ut-robotics/picr22-team-gibibot/(threads)

Thread 1 (2022-09-21):

[Mechanics] Add thrower to robot assembly

maidlam, 2022-09-21:
Add the thrower to the test robot assembly to check for any possible interference issues.

marcanderetti, 2022-09-22:
already did that, everything fits fine

marcanderetti, 2022-09-22:
Check the example subfolder - chassis assembling

Closed 2022-09-24.

Thread 10 (2022-09-21):

[Mechanics] How are the ball guides going to be fixed in place

maidlam, 2022-09-21:
How are the ball guides going to be fixed in place so they don't move around when in use?

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

marcanderetti, 2022-09-21:
The sticks will be replaced by M6 bolts

Akustav, 2022-09-24:
You need 70mm M6 bolts to make them work. I hope you have those, since I dont think we have such bolts in the lab and they seem quite exotic in their usecases.

marcanderetti, 2022-09-26:
> You need 70mm M6 bolts to make them work. I hope you have those, since I dont think we have such bolts in the lab and they seem quite exotic in their usecases.

I can take bolts from home and cut them to size. not going to be a problem

Closed 2022-09-26.

Thread 2 (2022-09-21):

[Mechanics] Dogbones missing from sidewalls

maidlam, 2022-09-21:
Assuming the sidewalls are going to be milled out, dogbones for sharp corners are missing.
https://ut-robotics.github.io/picr22-home/basketball_robot_guide/mechanics/design.html#_inside_sharp_corners

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

Akustav, 2022-09-24:
The current radius is 0.75mm. Is this intended? What sized mill do you plan to use?
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

marcanderetti, 2022-09-26:
I messed up the radius and diameter, will change it.

marcanderetti, 2022-09-26:
made new dogbones

Closed 2022-09-26.

Thread 3 (2022-09-21):

[Mechanics] Not clear where thrower motor cables run

maidlam, 2022-09-21:
From the current model it is unclear from where motor power cables run. Would be great if they can be found on the model, at least a representation of the cable exit area is needed.
Verify the location on your actual motor.

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

marcanderetti, 2022-09-22:
motor cables can turn in a 90 degree angle and won't get in the way. Alse we're not quite sure yet where to run the cables

Akustav, 2022-09-24:
I guess the whole motor attachment can be rotated to adjust the cable exit location. Overall I would suggest to run the cable from this area so it does not interfere with the ball or other elements of the thrower.

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

Closed 2022-09-24.

Thread 4 (2022-09-21):

[Mechanics] Text in sidewalls might not manufacturable

maidlam, 2022-09-21:
Assuming the walls are going to be milled, I think we don't have a small enough end mill to cut out the text in the walls.

marcanderetti, 2022-09-22:
removed the text

Akustav, 2022-09-24:
As a note, I have engravement tips for milling. They are conical 45,  60 and 90 degree mills. These can be used to mill text into components. They look something like this:

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

Closed 2022-09-24.

Thread 5 (2022-09-21):

[Mechanics] Motor spacer add mounting holes on other side

maidlam, 2022-09-21:
Since the motor is going to be attached to the motor spacer, the forces when a ball is thrown will get carried to the swing stick and the bolts at the front.
Adding mounting holes to the other side can add more rigidity.

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

marcanderetti, 2022-09-22:
made more mounting holes. all might not be usable due to interference with the swing

marcanderetti, 2022-09-22:
changed bolt mounting direction from motor mount -> spacer to spacer -> motor mount. Now all 8 bolts fit perfectly

Closed 2022-09-24.

Thread 6 (2022-09-21):

[Mechanics] Motor spacer holes wont support available bolts

maidlam, 2022-09-21:
The current holes for the bolt heads in the motor spacer have a diameter of 5 mm.
Heads of the bolts we have are 5,5 mm in diameter.

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

Screw heads are also taller than 2 mm.

Dimensions:
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
https://www.tme.eu/Document/569d510bbd6921a3db18021de3c420e1/B3x10_BN11.pdf

marcanderetti, 2022-09-22:
made the holes 5.55mm x 3.1mm.

Closed 2022-09-24.

Thread 7 (2022-09-21):

[Mechanics] Motor-side swing stick might have interference with motor shaft

maidlam, 2022-09-21:
Since the send of the motor-side swing stick is very close to the thrower motor's shaft, there might be interference, because the shaft sticks out quite a bit.
In the current model, the distance between these parts is 0,6 mm, which might not be enough.

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

marcanderetti, 2022-09-22:
the 3mm hole should have been enough, but i made a 4mm x 1mm hole just in case. This is an easy thing to manually fix later.

Closed 2022-09-24.

Thread 8 (2022-09-21):

[Mechanics] Fix warnings in timeline of assembly

maidlam, 2022-09-21:
There are a few warnings on the assembly timeline. These should be resolved.

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

marcanderetti, 2022-09-22:
Fixed warnings

Closed 2022-09-24.

Thread 9 (2022-09-21):

[Mechanics] Thrower motor spacer holes are not properly aligned

ReikoR, 2022-09-21:
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

Sketches aren't fully defined.
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

It's probably better to use circular pattern for these holes instead of having multiple sketch lines and dimensions.

marcanderetti, 2022-09-22:
made new holes using a circular pattern. everything should be fine now.

Closed 2022-09-24.

Thread 11 (2022-09-24):

[Mechanics] Difficult order of assembly

Akustav, 2022-09-24:
Currently the order of assembly for the motor spacer and motor are a little suspect.

First you need to attach the motor, else the sidewalls block the mounting holes:
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

After that you need you logically should attach the motor-spacer assembly to the sidewall but that is made difficult, because the attachment bolt heads can now interfere with the motor body:
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

Is this intentional?

marcanderetti, 2022-09-26:
made holes in motor mount so the motor screws could be added later.

marcanderetti, 2022-10-09:
I don't know how many times i have said this, but this is not meant to be adjustable. it just happens to be

Akustav, 2022-10-12:
Okay, I completely misunderstood it then. Can happen with text chats. Overall the design is quite confusing due to so many bolt holes in the component. You could remove the outer bolt circle entirely and mount the motor using its mounting holes, clamping the spacer between the motor and sidewall (blue holes). Otherwise you can remove around half the outer circle holes because there is no use for them (red crosses). The outer circle bolts still interfere with the motor so you can not remove the spacer without removing the motor completely.

A bolt does not in itself stop the pieces from moving relative to each other. The bolt provides clamping force to create friction between the two components. Shear forces apply in this case so a huge number of bolts is major overkill.

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

marcanderetti, 2022-10-17:
fixed it

Closed 2022-10-19.

Thread 12 (2022-09-24):

[Mechanics] Side swing stick questions

Akustav, 2022-09-24:
I was wondering how do you plan to manufacture those?

They seem to be a complex solution for a simple issue. Would it not be simpler to use a bolt with a blind threaded hole?

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

This reduces the count of unique components while providing the same result

marcanderetti, 2022-09-26:
I was planning to 3d print the stick, and screw from the other side. I thought it would look cooler like this.

Akustav, 2022-10-01:
What advantage except being cool would that provide? It seems more fragile and uses unique components that when lost/broken are more difficult to replace.

Additionally, how are these pieces fastened? The pieces themselves are 6mm, so what kind of screw will hold them in place?
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
The same issue is with the other side component that has the fastening hole on the swing arm.

Another thing is the weird sizing of the component stopper sides. One side has a 1mm lip, the other side has 6.4mm
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
I think you mentioned earlier that you had to add a hole to make room for the motors shaft. Why have the piece so long at all?

marcanderetti, 2022-10-02:
if the 6.4mm piece is so long, it will be held in place by the motor and won't need fastening. The other side will have a bolt and a spacer

Akustav, 2022-10-03:
Can't we just remove the side swing arms and all components associated with them? The main benefit of these swing arms is smooth motion when adjusting the throwing angle in runtime. This design does not support this approach.

You plan to clamp the internal moving components with the bolt. The two bolts have already fixed spacing with a grey piece. So the bolts can move in the slot and you can clamp the component sandwich without the arms.
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

Akustav, 2022-10-12:
I guess it can add a little support. Still one question remains that how will the ramp pivots fasten to the sidewalls.

Hole 1 is 3mm, hole 2 is 2.5mm. What combination of bolts and other fasteners are used there?

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

marcanderetti, 2022-10-19:
made both 2.5mm inside, so a screw can be added later. Also changed the direction of the swing stick, so a screw could be added from the outside
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

Closed 2022-10-20.

Thread 13 (2022-09-24):

[Mechanics] Upper guide stick and spacer question

Akustav, 2022-09-24:
Was wondering out of what you plan to do the spacer and stick?
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

Would it not be simpler to use a 10mm female-female spacer and 2 flat screws?

marcanderetti, 2022-09-26:
doesn't really matter, I was planning on 3d printing and press-fitting the stick. The model currently does not allow tolerance for screws

Akustav, 2022-10-01:
I do not think 3D-printing is a appropriate solution. It is not a catch-all answer. It should be attempted to avoid bespoke components that are ultra-specific. Maybe there is a better solution like using a F-F spacer fastened with recessed screw.

marcanderetti, 2022-10-02:
well then i can use a threaded rod and nuts. Really anything works that fits in between. It's not like it's going to mass production

Akustav, 2022-10-03:
In most cases it is good to use off-the-shelf components because they are easy to acquire and replace. It is good practice cause it reduces development time. Making one custom component is easy but when you need to 20 of said components, taking them off a shelf is better use of time and effort.

Anyways... Press-fitting 3D-printed sticks may break or take a lot of time to properly fit because tolerances for them are not that great. The stick may also be different in diameter across its length.

Threaded rods + nuts may interfere with the sliding action when you plan to fix it on both sides

marcanderetti, 2022-10-03:
i was meaning to cut a threaded rod to be the length of the stick. But anyways, by our availability of components, 3d printing a 5-minute print 4 times is still going to be faster than going to the hardware store. also, these thing don't have to be press-fitted THAT hard 😄

Akustav, 2022-10-03:
Compared to a hardware store it may be a good solution yeah but we should have a collection of spacers and these would be instantly available. I would also suggest using countersunk screws instead of normal socket cap head screws. It looks sleeker and does not interfere with any other moving parts.

marcanderetti, 2022-10-09:
Well i can look into it while manufacturing

Akustav, 2022-10-19:
It is possible to resolve before "looking into it while manufacturing". I suggest using 10 mm female-female spacers with M3 countersinks. This fixes everything in place rigidly.

marcanderetti, 2022-10-19:
Changed everything to adapt a 10mm spacer

marcanderetti, 2022-10-19:
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

Closed 2022-10-20.

Thread 14 (2022-09-24):

[Mechanics] too many blue lines

Akustav, 2022-09-24:
Currently sketches have too many blue undefined lines. All lines should be black and fully defined. This is important because when changes are required, all sketch dimensions are pre-determined and funky stuff can not happen. If lines are blue, any dimension change can have unforeseen consequences to the component.

Some examples:

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

marcanderetti, 2022-09-26:
Everything should be fixed now

Akustav, 2022-10-01:
I think everything is not fixed. Some things I found:

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

Overall I also think you have way to many sketches per component so it is hard to understand at times what is in scope for the component.

marcanderetti, 2022-10-02:
Will it really be a problem?

Akustav, 2022-10-03:
Yes. When I moved them so did the slots. For future components any wrong drag or sketch change can create a cascade of weird sketch transformations.

Closed 2022-10-12.

Thread 15 (2022-10-01):

[Mechanics] thrower motor too high

Akustav, 2022-10-01:
The motor seems too high compared to ball height. The ball might not touch the motor correctly

marcanderetti, 2022-10-02:
Awesome. The motor height was determined by instructors in the classroom

Akustav, 2022-10-03:
@maidlam @ReikoR WDYT?
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

maidlam, 2022-10-04:
Me and @ReikoR added these lines, one of them signifying the ground (on the right in the image, other line is on the bottom of the plate), into the assembly during a practical. I can't recall, if it accounted for sinking into the carpet.
The distance to the center of the motor from the bottom line is 55,115 mm, so 41,115 mm should be from the bottom of the motor to the ground.
Since a rubber tube or other soft material is planned to be added to the thrower motor, I think it will add enough thickness, so a ball can be grabbed.

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

Akustav, 2022-10-12:
Okay. With the rubber pay mind not to use too soft material that can deform in with high motor rotation speeds.

Closed 2022-10-12.

Thread 16 (2022-10-01):

[Mechanics] excessive play in angle adjustment

Akustav, 2022-10-01:
Currently the swing arms connect to the moving part of the ramp using a slot. Why is that? There seems  to be a lot of play there as well and the swing arms to not fix the ramp in place:

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

marcanderetti, 2022-10-02:
Obviously, it's meant to be adjustable. The whole assembly will be held together by the M6 bolts and friction.

Akustav, 2022-10-03:
This may be obvious for you but not obvious on first look.

Closed 2022-10-03.

Thread 17 (2022-10-01):

[Mechanics] interference in chassis assembly

Akustav, 2022-10-01:
Components interfere in the chassis assembly:

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

marcanderetti, 2022-10-02:
these parts won't ever be positioned so high, that they would interfere with this chassis. It's all adjustable

Thread 19 (2022-10-03):

[Mechanics] thrower can be hard to clamp when whole robot is assembled

Akustav, 2022-10-03:
Currently it is very difficult to fasten and release the the bolts because other parts of the chassis can be in the way.
To me it seems that it should be easily adjustable but when it can only be tweaked when removed from the robot removes flexibility that the design is supposed to add. Technically I think it is possible to place the thrower and other components in a manner that there is minimal interference but it requires some thought in the design.

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

Maybe you can use a universal joint driver but you use so large screws that the sockets for fastening will be large. Additionally you would need to hold both sides to tighten/release the bolts.

It is quite difficult to fix the access problem but the both side issue can be resolved by milling a pocket for the bolt heads that act as wrench. The pocket could be 2 or so mm deep.

marcanderetti, 2022-10-03:
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

Looks like it easily fits a 10mm flat wrench

Closed 2022-10-12.

Thread 20 (2022-10-03):

[Mechanics] tab holes larger than tabs

Akustav, 2022-10-03:
Currently the holes for mounting tabs of the thrower are large and don't locate the thrower. Is this intended?
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

marcanderetti, 2022-10-03:
This was changed because I had different sized tab holes on my model. Will change back to original.

marcanderetti, 2022-10-03:
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

Closed 2022-10-12.

Thread 21 (2022-10-12):

[Mechanics] No path for motor cables

Akustav, 2022-10-12:
There is currently no hole in the sidewall for the motor power cables. With the current mounting hole locations, one of these areas can be used:

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

This can be changed by rotating the motor mounting holes.

marcanderetti, 2022-10-17:
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
Power cables will run like this

Closed 2022-10-19.

Thread 25 (2022-10-30):

MCU pin assignement

ReikoR, 2022-10-30:
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

Did you use STM32CubeIDE for creating the pin assignment?
Based on the schematic I could not find pin assignment that would work.

For example timer 2 is already used for encoder and PA5 pin does not have any other timer channels available for PWM output:
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

Some more information on how to configure timers in STM32CubeIDE is on the firmware page:
https://ut-robotics.github.io/picr22-home/basketball_robot_guide/electronics/firmware.html

raimo0, 2022-11-02:
Fixed added servo pwm signal.

Closed 2022-11-05.

Thread 26 (2022-10-30):

Use more input and output capacitance for voltage regulators

ReikoR, 2022-10-30:
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

From [NCP164 datasheet](https://www.onsemi.com/pdf/datasheet/ncp164-d.pdf):
> **Input Decoupling (C<sub>IN</sub>)**
> It is recommended to connect at least 1 uF ceramic X5R or X7R capacitor between IN and GND pin of the device.

> **Output Decoupling (C<sub>OUT</sub>)**
> The device is designed to be stable with standard ceramics capacitors with values of 1 uF or greater.

NCV8730 regulator has the same problem.

Closed 2022-11-05.

Thread 27 (2022-10-30):

DRV8243 slew rate configuration

ReikoR, 2022-10-30:
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

Connecting 100k resistor to SR pin sets the slew rate to highest value:
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

This can't be read form the datasheet, but highest slew rate caused problems last year with motors not starting or rotating properly. Using slew rates of 23 or 28 V/usec worked fine.

raimo0, 2022-11-02:
Fixed

Closed 2022-11-05.

Thread 28 (2022-10-30):

Clearance between tracks is very small

ReikoR, 2022-10-30:
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

Signals on tracks will couple to adjacent tracks and cause noise. Typical recommendation is to keep tracks at least 3H apart, where H is distance between signal and reference layer. H for JLCPCB JLC3313 stackup is 0.1mm, so there should be at least 0.3 mm clearance between the tracks. If there is not enough room, then less clearance might be fine, but running traces in parallel should be minimised.

Tracks on the picture can be made narrower (0.2mm or 0.15mm) to create more space between them.

raimo0, 2022-11-02:
Made the tracks thinner and added more space between them.

Closed 2022-11-05.

Thread 29 (2022-10-30):

Via minimum annular ring size

ReikoR, 2022-10-30:
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

0.3/0.5 mm vias have annular ring size (0.1mm) that is under the minimum recommended size.

JLCPCB recommendation is 0.13mm. Smallest recommended via size is 0.2/0.45 mm (annular ring 0.125mm).
https://jlcpcb.com/capabilities/Capabilities

It's better to use 0.2/0.45 mm vias.

raimo0, 2022-11-02:
Fixed

Closed 2022-11-05.

Thread 30 (2022-10-30):

Make high current connections wider

ReikoR, 2022-10-30:
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

Current copper widths might work fine, but since there is room, it would make since to make copper polygons wider to help with current carrying and cooling capabilities.

1.63 mm conductor can carry about 5.4 A of current at 20 degree temperature rise:
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

Also if the currents share the same path then components on that path will see more noise from other components on that path. It's better to have separate (straight) path for each component.

Something like this would be much better:
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

On MCU side the entire half of the bottom layer could be 3.3V polygon.
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

raimo0, 2022-11-02:
Made the connections wider.

Closed 2022-11-05.

Thread 31 (2022-10-30):

Avoid placing reference designators below components

ReikoR, 2022-10-30:
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

It would be good if they are visible when components are on the board.

raimo0, 2022-11-02:
Fixed.

Closed 2022-11-05.

Thread 32 (2022-10-30):

Route USB data signals as differential pair

ReikoR, 2022-10-30:
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

USB data signals are 90 ohm differential pair and should be routed as such.
Tracks should be kept straight and symmetrical as possible to minimise impedance changes.
Correct impedance is achieved by varying width and spacing of the tracks.

JLCPCB has impedance calculator:
https://cart.jlcpcb.com/impedanceCalculation
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

According to the calculator, when using spacing of 8 mil (about 0.2 mm) the tracks have to be 6.03 mil (about 0.15 mm).

With Altium Designer's default settings, the differential pair net names have to end with (`_P` and `_N`):
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

On the schematic a differential pair directive and blanket over both pins should be added:
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

On properties panel of Differential Pair directive a Diff. Pair Net Class should be added:
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

In PcbDoc file, do Design -> Import:
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

Edit or create new Differential Pair Routing Rule:
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

Change component placement to allow differential tracks to be straight as possible:
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

Use Interactive Differential Pair Routing (Shift + Ctrl + W)
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

If stubs are created during routing, adjust the tracks manually to get rid of them. Stubs create reflections in signals.
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

Resulting diff pair tracks should be straight as possible with plenty of clearance between the pair and other tracks:
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

raimo0, 2022-11-02:
Routed the USB data as a differential pair.

Closed 2022-11-05.

Thread 34 (2022-10-30):

Programmer connector clearance

ReikoR, 2022-10-30:
Programmer connector is quite wide and won't fit with current encoder connector placement.

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

More info:
* https://ut-robotics.github.io/picr22-home/basketball_robot_guide/electronics/review_summary.html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
* https://github.com/ut-robotics/picr21-team-shaq/issues/52

raimo0, 2022-11-02:
Moved the connector

Closed 2022-11-05.

Thread 35 (2022-11-05):

Add more capacitance to switching regulator output

ReikoR, 2022-11-05:
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

100 nF is probably too little.

Texas Instruments Webench recommends 47 uF:
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
https://webench.ti.com/power-designer/switching-regulator?powerSupply=0

raimo0, 2022-11-05:
Fixed.

Closed 2022-11-06.

Thread 36 (2022-11-05):

Ball sensor

ReikoR, 2022-11-05:
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

Is the servo used for angle adjustment or ball holding?

For holding a ball sensor should be added. Otherwise it's hard to know when the servo should be stopped.

In the lab we have IS471FE sensors and 3mm IR LEDs.

raimo0, 2022-11-05:
The servo was for angle adjustment but I added a second servo for ball holding and a connector for the IR sensor.

ReikoR, 2022-11-06:
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

PA4 pin is not 5V tolerant.
From [datasheet](https://www.st.com/resource/en/datasheet/stm32g441kb.pdf):
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

Also `SERVO_PWN` should probably be `SERVO_PWM`:
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

raimo0, 2022-11-06:
Changed the IR sensor pin to PF0 and fixed the typos.

Closed 2022-11-06.

Thread 38 (2022-11-05):

Optimise switching regulator layout

ReikoR, 2022-11-05:
Connection to inductor can be made wider by moving the passible components.
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

Usually it's recommended to place smaller/lower capacitance capacitors closer to power inputs:
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

raimo0, 2022-11-05:
Optimised the layout.

Closed 2022-11-06.

Thread 39 (2022-11-06):

Mounting screw clearance

ReikoR, 2022-11-06:
Typical M3 screw head has diameter of 5.5 mm. One of the connectors is too close to the mounting hole:
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

raimo0, 2022-11-06:
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
Fixed.

Closed 2022-11-06.

Thread 41 (2022-11-16):

[Mechanics] suggest not using plastic parts for wheel - motor fastening

Akustav, 2022-11-16:
Team mu had a issue with their omniwheels where they used plastic and threaded inserts to fasten the wheel to the shaft of the motor. They also experienced failures to that area. I therefore suggest using the lathe to cut out a aluminum wheel fastener.

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

marcanderetti, 2022-11-20:
Will use an aluminium hub
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

Closed 2022-11-30.

Thread 43 (2022-11-16):

[Mechanics] holes in wheel covers very large

Akustav, 2022-11-16:
The holes on top of the wheel covers are currently very large, at 5.6mm. Is this intentional? How will it be fastened

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

marcanderetti, 2022-11-20:
made them smaller, for the different type of bolt
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

Closed 2022-11-30.

Thread 45 (2022-11-16):

[Mechanics] had to assemble top plate

Akustav, 2022-11-16:
If you want to have back support for the motors you should make the fit for these tabs loose to reduce the headache of assembly. The more tight fitting components there are, the harder the robot is to assemble.

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

marcanderetti, 2022-11-20:
Made motor mount ends diagonal so the assembly would be easier
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

Akustav, 2022-11-30:
Overall I would suggest having room on both X and Y axis

marcanderetti, 2022-12-02:
I will manualli sand down the edges after manufacturing

Closed 2022-12-03.

Thread 46 (2022-11-16):

[Mechanics] no camera on the model

Akustav, 2022-11-16:
There is currently no camera.
Additionally I suggest to fix the camera in place so it can not move. This reduces the danger of the camera moving and screwing with the adjustments done in code. A field of view cone will help you a lot

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

marcanderetti, 2022-11-21:
Fixed these issues
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

Akustav, 2022-11-30:
There is currently no room for the cameras USB cable:

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

marcanderetti, 2022-12-01:
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
fixed it

Closed 2022-12-03.

Thread 47 (2022-11-16):

[Mechanics] no batteries mounted

Akustav, 2022-11-16:
It is currently hard to see if a battery actually fits into the box inside the chassis.

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

marcanderetti, 2022-11-20:
The holder is bigger than the batteries, so that batteries would fit regardless of them being expanded or not

marcanderetti, 2022-11-21:
mounted a battery
![Uploading image.png…]()

Closed 2022-11-30.

Thread 48 (2022-11-16):

[Mechanics] you mount batteries low but PC high

Akustav, 2022-11-16:
You try to lower the center of gravity with mounting the batteries as low as possible but lift the second heaviest component, the PC higher. Why is that?

marcanderetti, 2022-11-17:
That is because I want to mount all electornics near the batteries. There is a slot for the PCB under the PC. The PC is just too big to fit it lower.

Thread 49 (2022-11-16):

[Mechanics] missjoined back wheel

Akustav, 2022-11-16:
The back wheel is currently not correctly joined:

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

marcanderetti, 2022-11-20:
fixed
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

Thread 50 (2022-11-16):

[Mechanics] interference between wheel and cover

Akustav, 2022-11-16:
There is some interference between the wheel rollers and the wheel cover. It is minimal on the perfect model but will most likely be worse on the actual machine. Try to make some room for the wheel.

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

marcanderetti, 2022-11-20:
made some extra room for the wheel

Thread 51 (2022-11-16):

[Mechanics] a bump in the roller slots

Akustav, 2022-11-16:
There is a bump in the roller slots. What is it for? If it is to support the roller, i suggest putting the supports as close to the shaft as possible. It might be hard to do so I suggest using a round slot for the shafts so it is simpler to add a lip in a way that it does not interfere with the rollers moving parts.

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

marcanderetti, 2022-11-20:
Made smaller and moved closer
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

Closed 2022-11-30.

Thread 52 (2022-11-16):

[Mechanics] no power plug or switches

Akustav, 2022-11-16:
There are currently no places for a power plug or switches on the chassis

marcanderetti, 2022-11-21:
Made holes for switches, power connectors etc
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

Akustav, 2022-11-30:
Current holes would not make it possible to mount switches, for example. I suggest consulting with some guidelines from here:
https://ut-robotics.github.io/picr22-home/basketball_robot_guide/mechanics/design.html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

marcanderetti, 2022-12-01:
Made adjustments
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

marcanderetti, 2022-12-02:
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

Closed 2022-12-03.

Thread 53 (2022-11-16):

[Mechanics] missalignment in thrower internal ramp

Akustav, 2022-11-16:
The assembly seems a little misaligned:

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

marcanderetti, 2022-11-21:
fixed

Closed 2022-11-30.

Thread 55 (2022-11-16):

[Mechanics] thrower can currently not be mounted

Akustav, 2022-11-16:
The tabs are too wide:

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

marcanderetti, 2022-11-20:
Cleared this issue
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

Closed 2022-11-30.

Thread 58 (2022-11-30):

RGB and robot axis misaligned

Akustav, 2022-11-30:
Currently these are misaligned. Is it intended?

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

marcanderetti, 2022-12-01:
Centered it
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

Closed 2022-12-03.

Thread 60 (2022-11-30):

Suggest to move robot armor inwards a little

Akustav, 2022-11-30:
I suggest to move the armor into the robot a little. This makes it harder to get balls stuck below the robot.

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

Something like this allows the ball to move up, instead of below the robot:

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

Closed 2022-12-03.

Thread 61 (2022-11-30):

Is this a hole for a spacer?

Akustav, 2022-11-30:
Is this hole meant to be for a spacer? Does it actually fit there? The spacer is a good idea but does not seem to currently fit.

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

marcanderetti, 2022-12-01:
added the spacer, moved the hole a little
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

Closed 2022-12-03.

Thread 62 (2022-11-30):

Ball floating between roller and thrower motor

Akustav, 2022-11-30:
Currently the ball is not fed into the thrower by the roller:

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

I suggest something like a double-internal ramp where the roller has its own little curve that feeds the ball into the thrower without release of too much pressure. Something like this:

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

marcanderetti, 2022-12-01:
Modified the ramp. Thank you!
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

Closed 2022-12-03.

Thread 63 (2022-11-30):

Almost zero clearance on robot thrower

Akustav, 2022-11-30:
There is almost no clearance on the robot. It might get stuck on the carpet and will have a very hard time moving sideways due to its parts dragging on the carpet. Additionally there is no room for any screws to mount the extra centering rails.

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

I suggest not having the additional rails or have them around 5mm off the ground.

marcanderetti, 2022-12-01:
Made some clearance changes
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

Closed 2022-12-03.

Thread 64 (2022-11-30):

No sensor to detect where ball is in the thrower

Akustav, 2022-11-30:
There currently is no way to detect how much a ball has been grabbed. This can lead to the situation where you unintentionally throw it when wanting to hold it. I suggest adding a IR sensor to around here that signals the mainboard that a ball is well located in the thrower.

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

marcanderetti, 2022-12-01:
made holes for IR sensor
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

Akustav, 2022-12-03:
This sensor position should work yeah but what holds the sensor and LED in place? I suggest a little plate that pushes the sensor into its socket and is fastened with 1-2 screws:

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

marcanderetti, 2022-12-03:
Made a bracket to hold the LED and the sensor. The paint shows how the prongs will be routed
Sensor side:
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
LED side:
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

Closed 2022-12-03.

Thread 66 (2022-11-30):

No electronics attached to the robot

Akustav, 2022-11-30:
You should have a place for the mainboard and step-up converter inside the chassis.

marcanderetti, 2022-12-01:
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

Akustav, 2022-12-03:
You will most likely not be able to fit the SUB in the mainboard without some additional cutouts:

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

marcanderetti, 2022-12-03:
Made a bigger hole in the camera holder, so cables could be routed
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

Closed 2022-12-03.

Thread 68 (2022-12-03):

No room for screw that holds extended ramp to robot

Akustav, 2022-12-03:
There seems to be no room for a normal screw here:

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

Akustav, 2022-12-03:
I also suggest to use countersunk screws here as well:
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

marcanderetti, 2022-12-03:
I will be using countershrunk screws in places like these
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

marcanderetti, 2022-12-03:
Also made the front a bit thicker, for added strength
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

Akustav, 2022-12-03:
The component is 3D printed so you should model the chamfers there as well. Drilling them afterward can compromise the 3D printed component.

marcanderetti, 2022-12-04:
added chamfter on the parts
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

Closed 2022-12-04.

Thread 69 (2022-12-03):

Thrower motor cable hole goes nowhere

Akustav, 2022-12-03:
The hole leads nowhere currently:

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

marcanderetti, 2022-12-03:
I deemed it too much to sketch, so i just shortened the cable
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

Akustav, 2022-12-03:
I think you missed the point. Where does the cable run? The hole is above the top plate so the cable cant go into the chassis.

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

marcanderetti, 2022-12-04:
Oh right... I completely missed that little detail 🤣
Made a little hole thingy for the cable
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

Closed 2022-12-04.

Thread 70 (2022-12-03):

Do you plan to fasten the servo horn to the servo?

Akustav, 2022-12-03:
There should be a screw that fixes the horn to the servo. Do you plan to use it or is there another solution?

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

marcanderetti, 2022-12-03:
Yes, there is a screw. I didn't see a point in modelling that, since it doesn't change anything

Closed 2022-12-03.
