ut-robotics/picr22-team-gibibot/electronics/picr22-team-GibiBot-mainboard/picr22-team-GibiBot-mainboard.pdf

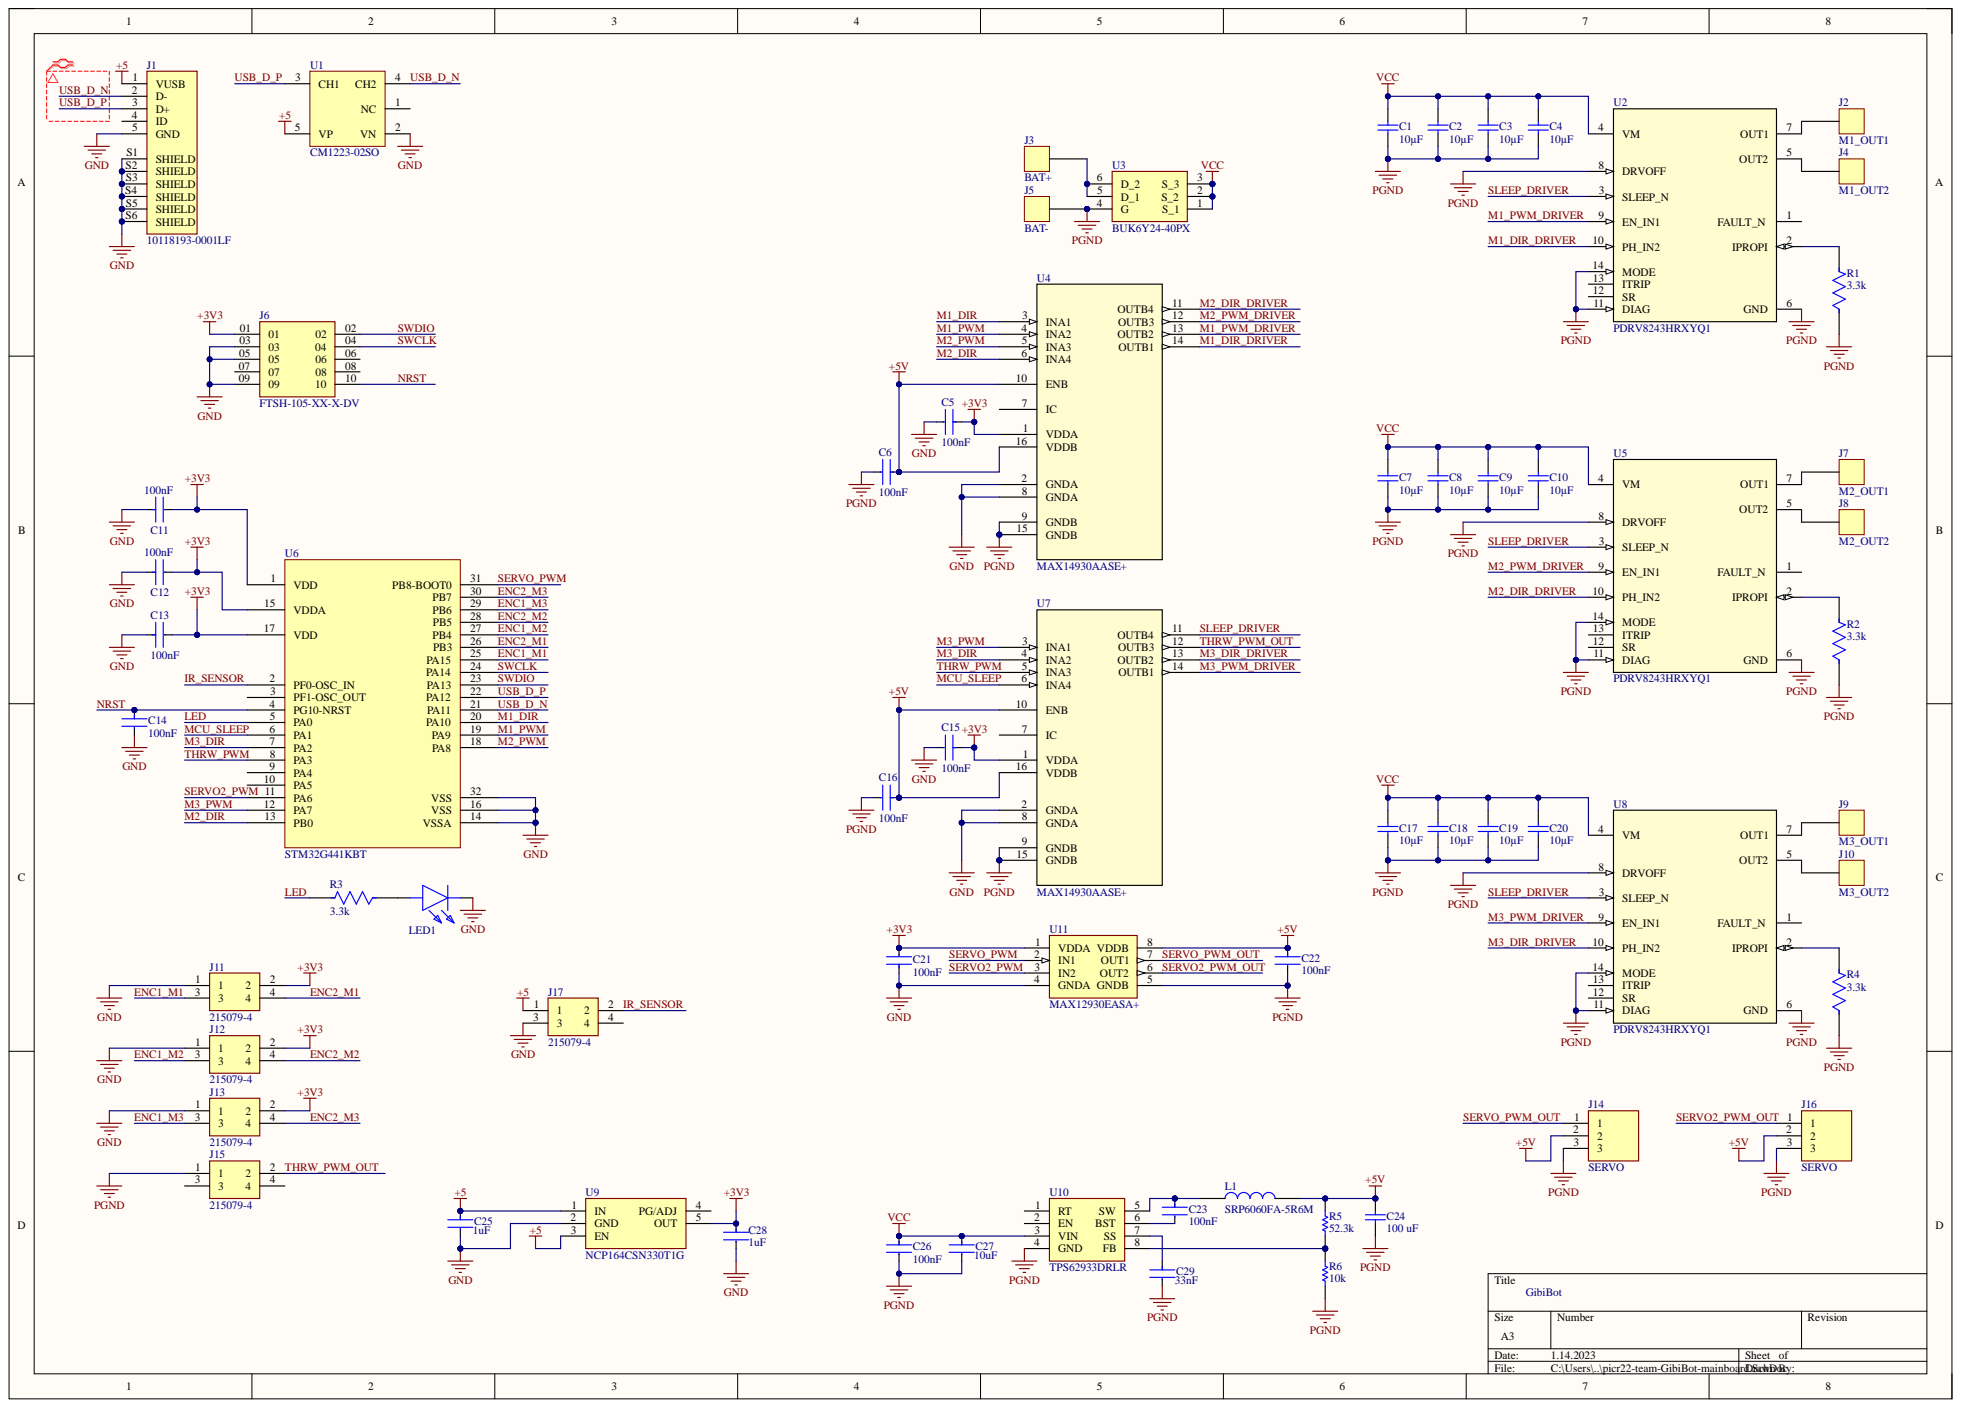
[picture p2: page 1]

05 05
07 07
09 09
