ut-robotics/picr22-team-gibibot/(list of files, drawings)

Other design files:
electronics/picr22-team-GibiBot-mainboard/picr22-team-GibiBot-mainboard.PcbDoc
electronics/picr22-team-GibiBot-mainboard/picr22-team-GibiBot-mainboard.PcbLib
electronics/picr22-team-GibiBot-mainboard/picr22-team-GibiBot-mainboard.PrjPcb
electronics/picr22-team-GibiBot-mainboard/picr22-team-GibiBot-mainboard.SchDoc
electronics/picr22-team-GibiBot-mainboard/picr22-team-GibiBot-mainboard.SchLib
