ut-robotics/picr22-team-gibibot/firmware/gibibot_firmware/Core/Src/main.c

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
/* Includes ------------------------------------------------------------------*/
#include "main.h"
#include "usb_device.h"

/* USER CODE BEGIN Includes */
#include "usbd_cdc_if.h"
/* USER CODE END Includes */

TIM_HandleTypeDef htim1;
TIM_HandleTypeDef htim2;
TIM_HandleTypeDef htim3;
TIM_HandleTypeDef htim4;
TIM_HandleTypeDef htim6;
TIM_HandleTypeDef htim8;
TIM_HandleTypeDef htim15;
TIM_HandleTypeDef htim16;
TIM_HandleTypeDef htim17;

void SystemClock_Config(void);
static void MX_GPIO_Init(void);
static void MX_TIM1_Init(void);
static void MX_TIM2_Init(void);
static void MX_TIM3_Init(void);
static void MX_TIM4_Init(void);
static void MX_TIM15_Init(void);
static void MX_TIM16_Init(void);
static void MX_TIM17_Init(void);
static void MX_TIM8_Init(void);
static void MX_TIM6_Init(void);
/* USER CODE BEGIN 0 */
typedef struct Command {
  int16_t speed1;
  int16_t speed2;
  int16_t speed3;
  uint16_t throwerSpeed;
  uint16_t throwerAngle;
  uint16_t throwerGrab;
  uint16_t delimiter;
} Command;

typedef struct Feedback {
  int16_t ballDetected;
  uint16_t delimiter;
} Feedback;

int16_t IRsensor;

typedef struct MotorControl {
	int16_t gainP;
	int16_t gainI;
	int16_t gainD;
	int32_t integral;
	int16_t positionChange;
	int16_t position;
} MotorControl;

MotorControl motorControl1 = {.position = 0, .positionChange = 0, .gainP = 1000, .gainI = 50, .gainD = 10, .integral = 0};
MotorControl motorControl2 = {.position = 0, .positionChange = 0, .gainP = 1000, .gainI = 50, .gainD = 10, .integral = 0};
MotorControl motorControl3 = {.position = 0, .positionChange = 0, .gainP = 1000, .gainI = 50, .gainD = 10, .integral = 0};

Command command = {
		.speed1 = 0,
		.speed2 = 0,
		.speed3 = 0,
		.throwerSpeed = 0,
		.throwerAngle = 6900,
		.throwerGrab = 4800,
		.delimiter = 0};

volatile uint8_t isCommandReceived = 0;

void CDC_On_Receive(uint8_t* buffer, uint32_t* length) {
  if (*length == sizeof(Command)) {
    memcpy(&command, buffer, sizeof(Command));

    if (command.delimiter == 0xAAAA) {
      isCommandReceived = 1;
    }
  }
}

int32_t ClampValueI32(int32_t val, int32_t min, int32_t max) {
	if (val < min) {
		return min;
	}
	if (val > max) {
		return max;
	}
	return val;
}

uint16_t ClampValueU16(uint16_t val, uint16_t min, uint16_t max) {
	if (val < min) {
		return min;
	}
	if (val > max) {
		return max;
	}
	return val;
}

int32_t ControlMotor(MotorControl* motorControl, int16_t position, int16_t set_speed) {
	motorControl->positionChange = (position-motorControl->position); //Calculates the position change
	int16_t error = (set_speed-motorControl->positionChange); //Calculates the error
	motorControl->integral+=error;
	motorControl->integral=ClampValueI32(motorControl->integral, -65535/motorControl->gainI, 65535/motorControl->gainI); //Adds the errors together and clamps the value
	motorControl->position = position; //Previous position is now the current position
	return (error*motorControl->gainP + motorControl->gainI*motorControl->integral + motorControl->positionChange*motorControl->gainD);
}

void EnableMotorDrivers() {
	HAL_GPIO_WritePin(GPIOA, GPIO_PIN_1, GPIO_PIN_SET);
	for (int i = 0; i < 350; i++) {
	  __asm("nop");
	}
	HAL_GPIO_WritePin(GPIOA, GPIO_PIN_1, GPIO_PIN_RESET);
	for (int i = 0; i < 350; i++) {
	  __asm("nop");
	}
	HAL_GPIO_WritePin(GPIOA, GPIO_PIN_1, GPIO_PIN_SET);
}

void UpdateServosAndThrower() {
	//Start thrower speed < 3200
	//Thrower speed between 3200 and 6400
	TIM15->CCR2 = command.throwerSpeed+3150;
	//Thrower angle
	TIM8->CCR2 = ClampValueU16(command.throwerAngle, 2700, 6900);
	//Grabber
	TIM16->CCR1 = ClampValueU16(command.throwerGrab, 2700, 6900);
}

void HAL_TIM_PeriodElapsedCallback(TIM_HandleTypeDef *htim) {
	//Reading the motor encoders and calculating motor pwm
	int32_t motor1PWM = ClampValueI32(ControlMotor(&motorControl1, (int16_t)TIM2->CNT, command.speed1), -65535, 65535);
	//Direction M1
	if (motor1PWM < 0) {
		HAL_GPIO_WritePin(M1_DIR_GPIO_Port, M1_DIR_Pin, 0);
	} else {
		HAL_GPIO_WritePin(M1_DIR_GPIO_Port, M1_DIR_Pin, 1);
	}
	int32_t motor2PWM = ClampValueI32(ControlMotor(&motorControl2, (int16_t)TIM3->CNT, command.speed2), -65535, 65535);
	//Direction M2
	if (motor2PWM < 0) {
		HAL_GPIO_WritePin(M2_DIR_GPIO_Port, M2_DIR_Pin, 0);
	} else {
		HAL_GPIO_WritePin(M2_DIR_GPIO_Port, M2_DIR_Pin, 1);
	}
	int32_t motor3PWM = ClampValueI32(ControlMotor(&motorControl3, (int16_t)TIM4->CNT, command.speed3), -65535, 65535);
	//Direction M3
	if (motor3PWM < 0) {
		HAL_GPIO_WritePin(M3_DIR_GPIO_Port, M3_DIR_Pin, 0);
	} else {
		HAL_GPIO_WritePin(M3_DIR_GPIO_Port, M3_DIR_Pin, 1);
	}
	//Changing motor pwm
	TIM1->CCR2 = abs(motor1PWM);
	TIM1->CCR1 = abs(motor2PWM);
	TIM17->CCR1 = abs(motor3PWM);
}

/* USER CODE END 0 */

/**
  * @brief  The application entry point.
  * @retval int
  */
int main(void)
{
  /* MCU Configuration--------------------------------------------------------*/

  /* Reset of all peripherals, Initializes the Flash interface and the Systick. */
  HAL_Init();

  /* Configure the system clock */
  SystemClock_Config();

  /* Initialize all configured peripherals */
  MX_GPIO_Init();
  MX_TIM1_Init();
  MX_TIM2_Init();
  MX_TIM3_Init();
  MX_TIM4_Init();
  MX_TIM15_Init();
  MX_TIM16_Init();
  MX_TIM17_Init();
  MX_USB_Device_Init();
  MX_TIM8_Init();
  MX_TIM6_Init();
  /* USER CODE BEGIN 2 */

  Feedback feedback = {
		.ballDetected = 0,
        .delimiter = 0xAAAA
    };

  //ENCODERS
  HAL_TIM_Encoder_Start(&htim2, TIM_CHANNEL_1 | TIM_CHANNEL_2); //M1 encoder
  HAL_TIM_Encoder_Start(&htim3, TIM_CHANNEL_1 | TIM_CHANNEL_2); //M2 encoder
  HAL_TIM_Encoder_Start(&htim4, TIM_CHANNEL_1 | TIM_CHANNEL_2); //M3 encoder
  //PWM
  HAL_TIM_PWM_Start(&htim1, TIM_CHANNEL_1);    //M2 PWM
  HAL_TIM_PWM_Start(&htim1, TIM_CHANNEL_2);    //M1 PWM
  HAL_TIM_PWM_Start(&htim17, TIM_CHANNEL_1);   //M3 PWM
  HAL_TIM_PWM_Start(&htim15, TIM_CHANNEL_2);   //THROWER PWM
  HAL_TIM_PWM_Start(&htim8, TIM_CHANNEL_2);    //SERVO1
  HAL_TIM_PWM_Start(&htim16, TIM_CHANNEL_1);   //SERVO2

  HAL_TIM_Base_Start_IT(&htim6); //Timer for motor speed

  //Wakes up the thrower
  TIM15->CCR2 = 3150;
  /* USER CODE END 2 */

  /* Infinite loop */
  /* USER CODE BEGIN WHILE */
  while (1)
  {
	UpdateServosAndThrower();
	IRsensor = HAL_GPIO_ReadPin(IR_SENSOR_GPIO_Port, IR_SENSOR_Pin);
	HAL_GPIO_WritePin(DEBUG_LED_GPIO_Port, DEBUG_LED_Pin, IRsensor);
    /* USER CODE END WHILE */

    /* USER CODE BEGIN 3 */
	if (isCommandReceived) {
		isCommandReceived = 0;

		EnableMotorDrivers(); //Sends the nsleep signal to motor drivers
		feedback.ballDetected = IRsensor;

		CDC_Transmit_FS((uint8_t*)&feedback, (uint16_t)sizeof(feedback));
    }
  }
  /* USER CODE END 3 */
}

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
