ut-robotics/picr22-team-gibibot/firmware/gibibot_firmware/gibibot_firmware.ioc

Mcu.UserName=STM32G441KBTx
PA0.GPIO_Label=DEBUG_LED
PA0.Signal=GPIO_Output
PA1.Signal=GPIO_Output
PA10.GPIO_Label=M1_DIR
PA10.Signal=GPIO_Output
PA11.Signal=USB_DM
PA12.Signal=USB_DP
PA13.Signal=SYS_JTMS-SWDIO
PA14.Signal=SYS_JTCK-SWCLK
PA15.GPIO_Label=ENC1_M1
PA15.Signal=S_TIM2_CH1
PA2.GPIO_Label=M3_DIR
PA2.Signal=GPIO_Output
PA3.GPIO_Label=THRW_PWM
PA3.Signal=S_TIM15_CH2
PA6.GPIO_Label=SERVO2_PWM
PA6.Signal=S_TIM16_CH1
PA7.GPIO_Label=M3_PWM
PA7.Signal=S_TIM17_CH1
PA8.GPIO_Label=M2_PWM
PA8.Signal=S_TIM1_CH1
PA9.GPIO_Label=M1_PWM
PA9.Signal=S_TIM1_CH2
PB0.GPIO_Label=M2_DIR
PB0.Signal=GPIO_Output
PB3.GPIO_Label=ENC2_M1
PB3.Signal=S_TIM2_CH2
PB4.GPIO_Label=ENC1_M2
PB4.Signal=S_TIM3_CH1
PB5.GPIO_Label=ENC2_M2
PB5.Signal=S_TIM3_CH2
PB6.GPIO_Label=ENC1_M3
PB6.Signal=S_TIM4_CH1
PB7.GPIO_Label=ENC2_M3
PB7.Signal=S_TIM4_CH2
PB8-BOOT0.GPIO_Label=SERVO1_PWM
PB8-BOOT0.Signal=S_TIM8_CH2
PF0-OSC_IN.GPIO_Label=IR_SENSOR
PF0-OSC_IN.Signal=GPIO_Input
