ut-robotics/picr22-team-gibibot/firmware/gibibot_firmware/Core/Inc/main.h

#define IR_SENSOR_Pin GPIO_PIN_0
#define IR_SENSOR_GPIO_Port GPIOF
#define DEBUG_LED_Pin GPIO_PIN_0
#define DEBUG_LED_GPIO_Port GPIOA
#define M3_DIR_Pin GPIO_PIN_2
#define M3_DIR_GPIO_Port GPIOA
#define THRW_PWM_Pin GPIO_PIN_3
#define THRW_PWM_GPIO_Port GPIOA
#define SERVO2_PWM_Pin GPIO_PIN_6
#define SERVO2_PWM_GPIO_Port GPIOA
#define M3_PWM_Pin GPIO_PIN_7
#define M3_PWM_GPIO_Port GPIOA
#define M2_DIR_Pin GPIO_PIN_0
#define M2_DIR_GPIO_Port GPIOB
#define M2_PWM_Pin GPIO_PIN_8
#define M2_PWM_GPIO_Port GPIOA
#define M1_PWM_Pin GPIO_PIN_9
#define M1_PWM_GPIO_Port GPIOA
#define M1_DIR_Pin GPIO_PIN_10
#define M1_DIR_GPIO_Port GPIOA
#define ENC1_M1_Pin GPIO_PIN_15
#define ENC1_M1_GPIO_Port GPIOA
#define ENC2_M1_Pin GPIO_PIN_3
#define ENC2_M1_GPIO_Port GPIOB
#define ENC1_M2_Pin GPIO_PIN_4
#define ENC1_M2_GPIO_Port GPIOB
#define ENC2_M2_Pin GPIO_PIN_5
#define ENC2_M2_GPIO_Port GPIOB
#define ENC1_M3_Pin GPIO_PIN_6
#define ENC1_M3_GPIO_Port GPIOB
#define ENC2_M3_Pin GPIO_PIN_7
#define ENC2_M3_GPIO_Port GPIOB
#define SERVO1_PWM_Pin GPIO_PIN_8
#define SERVO1_PWM_GPIO_Port GPIOB
