ut-robotics/picr22-team-gibibot/software/camera.py

import pyrealsense2 as rs
import numpy as np
import math
import cv2


class ICamera:
    def open(self):
        pass
    def close(self):
        pass
    def has_depth_capability(self) -> bool:
        pass
    def get_color_frame(self):
        pass
    def get_frames(self):
        pass
    
# Camera implementation using the pyrealsense2 provided API 
class RealsenseCamera(ICamera):
    def __init__(self, 
                rgb_width = 848, 
                rgb_height = 480,
                rgb_framerate = 60,
                depth_width = 848, 
                depth_height = 480,
                depth_framerate = 60,
                exposure = 50, 
                white_balace = 3500,
                depth_enabled = True):

        self.rgb_width = rgb_width
        self.rgb_height = rgb_height
        self.rgb_framerate = rgb_framerate
        self.exposure = exposure
        self.white_balace = white_balace

        self.depth_width = depth_width
        self.depth_height = depth_height
        self.depth_framerate = depth_framerate

        self.pipeline = rs.pipeline()
        self.config = rs.config()
        self.config.enable_stream(rs.stream.color, self.rgb_width, self.rgb_height, rs.format.bgr8, self.rgb_framerate)
        
        self.depth_enabled = depth_enabled
        if self.depth_enabled:
            self.config.enable_stream(rs.stream.depth, self.depth_width, self.depth_height, rs.format.z16, self.depth_framerate)
            
        self.align = rs.align(rs.stream.color)
        self.depth_scale = -1

    def open(self):
        profile = self.pipeline.start(self.config)
        color_sensor = profile.get_device().query_sensors()[1]
        color_sensor.set_option(rs.option.enable_auto_exposure, False)
        color_sensor.set_option(rs.option.enable_auto_white_balance, False)
        color_sensor.set_option(rs.option.white_balance, self.white_balace)
        color_sensor.set_option(rs.option.exposure, self.exposure)

        depth_sensor = profile.get_device().first_depth_sensor()
        self.depth_scale = depth_sensor.get_depth_scale()

    def close(self):
        self.pipeline.stop()
    
    def get_color_frame(self):
        frames = self.pipeline.wait_for_frames()
        return np.asanyarray(frames.get_color_frame().get_data())
    
    def has_depth_capability(self) -> bool:
        return self.depth_enabled


    def get_frames(self, aligned = False):
        frames = self.pipeline.wait_for_frames()
        if aligned:
            frames = self.align.process(frames)
        #esimene list on colour frame ja teine list on depth frame
        return np.asanyarray(frames.get_color_frame().get_data()), np.asanyarray(frames.get_depth_frame().get_data())


# resolution numbers are sensitive with openCV. Implement a resolution setting mechanism here or use the default of the webcam to
# get a more robust solution
class OpenCVCamera(ICamera):
    def __init__(self, 
                rgb_width = 1920, 
                rgb_height = 1080,
                rgb_framerate = 30,
                id = 0):

        self.rgb_width = rgb_width
        self.rgb_height = rgb_height
        self.rgb_framerate = rgb_framerate

        self.camera_id = id
        self.camera_stream = None

    def open(self):
        self.camera_stream = cv2.VideoCapture(self.camera_id)


    def close(self):
        self.camera_stream.release()


    def has_depth_capability(self) -> bool:
        return False

    def get_color_frame(self):
        ret, frame = self.camera_stream.read()
        return frame


    def get_frames(self):
        ret, frame = self.camera_stream.read()
        return frame, np.zeros(frame.shape, dtype=int)
