ut-robotics/picr22-team-gibibot/software/jit_functions.py

from numba import jit
import numpy as np

@jit(nopython=True)
def color_sequence(column):
    count_thresh = 10
    counter = 0
    last_colour = -1
    sequence = []

    if len(column) == 0:
        return sequence

    for i in range(len(column)):
        element = column[i] 
        if element == 0:
            continue
        if element == last_colour:
            counter += 1
        else:
            last_colour = element
            counter = 0
        if counter > count_thresh:
            sequence.append(element)
    # if len(sequence) == 0:
    #     sequence = [np.array([1], dtype=np.uint8)[0]]
    return sequence

@jit(nopython=True)
def is_inside(sequence):
    last_colour = -1
    value = False
    
    if 6 not in sequence:
        value = True
        return value
    for i in sequence:
        if i == 6:#BLACK
            if last_colour == 5:#WHITE
                value = True
            elif last_colour == 4:#ORANGE
                value = False
        last_colour = i
    if sequence[-1] == 1:
        value =  True
    return value    

# Real Data:  0 0 0 43690
# FILTERED LINE:  [4, 4, 4, 4, 6, 6, 6, 6, 5, 6, 5, 5, 5, 5, 4, 4, 4, 4]
# True
# FILTERED LINE:  [4, 4, 4, 4, 6, 6, 6, 6, 5, 5, 5, 5, 4, 4, 4, 4]
# False
