ut-robotics/picr22-team-gibibot/(commit log)

2022-10-24 Schematic and PCB design
    [STM32G441KB.PcbLib, picr22-team-GibiBot-mainboard.PcbDoc, picr22-team-GibiBot-mainboard.PcbLib, picr22-team-GibiBot-mainboard.PrjPcb, picr22-team-GibiBot-mainboard.SchDoc, picr22-team-GibiBot-mainboard.SchLib, picr22-team-GibiBot-mainboard1.SchDoc]
2022-11-02 Add files via upload
    Thrower calibration
2022-11-02 Fixed the issues, added switching regulator, isolator and servo
    [picr22-team-GibiBot-mainboard.PcbDoc, picr22-team-GibiBot-mainboard.PcbLib, picr22-team-GibiBot-mainboard.PrjPcb, picr22-team-GibiBot-mainboard.SchDoc, picr22-team-GibiBot-mainboard.SchLib]
2022-11-02 Add files via upload
    Removed issues
    [calculations.py, communication.py, main.py, movement.py]
2022-11-05 Fixed issues, added second servo and IR sensor connector
    [picr22-team-GibiBot-mainboard.PcbDoc, picr22-team-GibiBot-mainboard.PrjPcb, picr22-team-GibiBot-mainboard.SchDoc]
2022-11-06 Changed the IR sensor pin and fixed a typo
    [picr22-team-GibiBot-mainboard.PcbDoc, picr22-team-GibiBot-mainboard.SchDoc]
2022-11-06 Fixed mounting hole clearance and added gerber files
    [picr22-team-GibiBot-mainboard.PcbDoc, picr22-team-GibiBot-mainboard.PrjPcb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]
2022-11-07 Add files via upload
    image processing and thrower calibration
2022-12-09 Fixed pull request issues.
    [calculations.py]
2022-12-10 Changed the sensor feedback
2023-01-12 Added BOM and pdf, fixed the incorrect connections on the pcb and generated new gerber files
    [picr22-team-GibiBot-mainboard-BOM.tsv, picr22-team-GibiBot-mainboard.PcbDoc, picr22-team-GibiBot-mainboard.PrjPcb, picr22-team-GibiBot-mainboard.SchDoc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]
2023-01-14 Fixed the incorrect programmer connector pinout
    [picr22-team-GibiBot-mainboard.PcbDoc, picr22-team-GibiBot-mainboard.PrjPcb, picr22-team-GibiBot-mainboard.SchDoc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]
