ut-robotics/picr22-team-gibibot/(notices)

Notices in the files:
firmware/gibibot_firmware/Core/Src/main.c:
Copyright (c) 2022 STMicroelectronics.
All rights reserved.
This software is licensed under terms that can be found in the LICENSE file
